Evidlo/motorcontroller/motor5/render/bottom.png

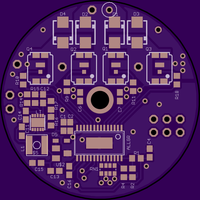
motor5/render/bottom.png
