Evidlo/motorcontroller/motor5/revision.md

* pending
    * increase size of C14 so it can be upgraded to a 50V rated cap

* applied
    * increase creepage on R9 and R11
    * change silkscreen version
    * 5k -> 1k
    * increase hole size for V+, GND, M+ and M- pins
    * move vias from under fets
    * increase hole size for bulk cap

    Attiny Pinout
