Evidlo/motorcontroller/motor7/plots/plots.docx

Side A Active (side A sourcing current)

Voltage across side A bootstrap

Voltage across side B bootstrap

Voltage on low side A FET gate

Voltage on low side B FET gate

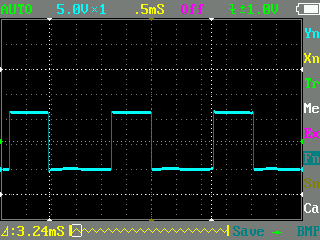
[picture p2: figure]

Side B Active (side B sourcing current)

Voltage across side A bootstrap

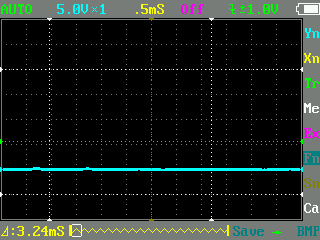
[picture p3: figure]

Voltage across side B bootstrap

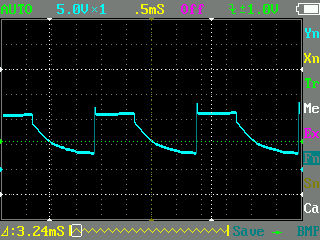
[picture p4: figure]

Voltage on low side A FET gate

Voltage on low side A FET gate

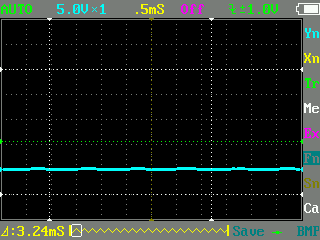
[picture p5: figure]
