Evidlo/motorcontroller/motor2/render/motor2-bottom.png

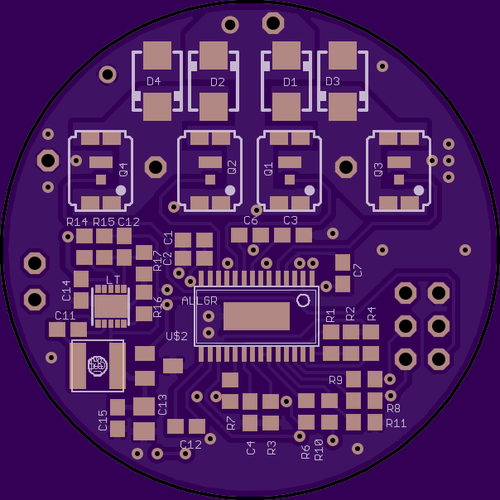
motor2/render/motor2-bottom.png
