Evidlo/motorcontroller/motor2/render/motor2-top.png

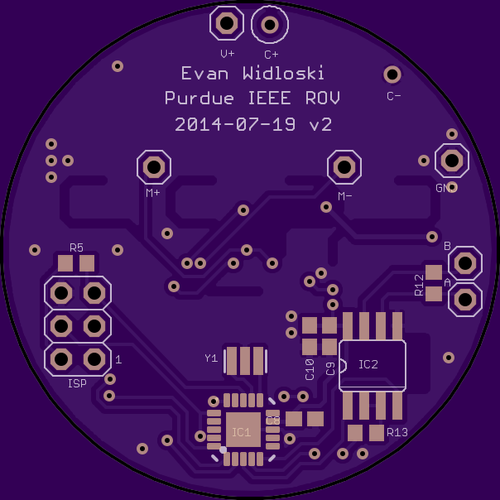
motor2/render/motor2-top.png
