Evidlo/motorcontroller/motor5/render/top.png

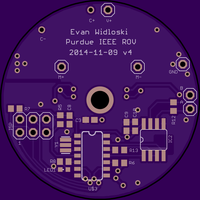
motor5/render/top.png
