Evidlo/motorcontroller/motor2/motor2_bom (Evan Widloski's conflicted copy 2014-08-30).ods

Seabotix Motor Controller BOM |  |  | 2014-07-22 | Evan Widloski
Qty | Value | Nom. Rating | Package | Parts | URL | Digikey Cost | Qty to Buy | Cost | Notes
1 |  |  | PINHD-2X3 | ISP
5 | .1uF | 25V | C-USC0603 | C2, C4, C8, C10, C16 | http://www.digikey.com/product-detail/en/CC0603ZRY5V9BB104/311-1343-1-ND/2103127 | 0.1 | 5 | 0.5
1 | .22uF | 25V | C-USC0603 | C11 | http://www.digikey.com/product-detail/en/TMK107B7224KA-T/587-1246-1-ND/931023 | 0.1 | 1 | 0.1
1 | 1M |  | R-US_R0603 | R15 | http://www.digikey.com/product-detail/en/RC0603FR-071ML/311-1.00MHRCT-ND/729791 | 0.1 | 1 | 0.1
2 | 1k |  | R-US_R0603 | R5, R10 | http://www.digikey.com/product-detail/en/RMCF0603JT1K00/RMCF0603JT1K00CT-ND/1943173 | 0.02 | 2 | 0.04
4 | 1uF | 25V | C-USC0603 | C3, C6, C7, C12 | http://www.digikey.com/product-detail/en/TMK107B7105KA-T/587-2984-1-ND/2714177 | 0.1 | 4 | 0.4
1 | 2.2uF | 100V | C-USC0603 | C13 | http://www.digikey.com/product-detail/en/CC0603ZRY5V5BB225/311-1452-1-ND/2833758 | 0.11 | 1 | 0.11
8 | 3k |  | R-US_R0603 | R1, R2, R6, R8, R11, R12, R14, R17 | http://www.digikey.com/product-detail/en/RMCF0603JT3K30/RMCF0603JT3K30CT-ND/1943182 | 0.02 | 8 | 0.16
2 | 10k |  | R-US_R0603 | R9, R13 | http://www.digikey.com/product-detail/en/RMCF0603JT10K0/RMCF0603JT10K0CT-ND/1943191 | 0.02 | 2 | 0.04
1 | 22pF | 25V | C-USC0603 | C15 | http://www.digikey.com/product-detail/en/C1608C0G1H220J080AA/445-1273-1-ND/567670 | 0.1 | 1 | 0.1
1 | 22uF | 25V | C-USC0603 | C14 | http://www.digikey.com/product-detail/en/CL21A226MAQNNNE/1276-2908-1-ND/3890994 | 0.47 | 1 | 0.47
2 | 51k |  | R-US_R0603 | R4,R7 | http://www.digikey.com/product-detail/en/RMCF0603FT51K1/RMCF0603FT51K1CT-ND/1943103 | 0.04 | 2 | 0.08
2 | 68nF | 25V | C-USC0603 | C1, C5 | http://www.digikey.com/product-detail/en/GRM188R71E683KA01D/490-1523-1-ND/587864 | 0.1 | 2 | 0.2
1 | 100K |  | R-US_R0603 | R16 | http://www.digikey.com/product-detail/en/RMCF0603FT100K/RMCF0603FT100KCT-ND/1943118 | 0.04 | 1 | 0.04
1 | 120 |  | R-US_R0603 | R3 | http://www.digikey.com/product-detail/en/RMCF0603JT120R/RMCF0603JT120RCT-ND/1943157 | 0.02 | 1 | 0.02
1 | ALLEGRO-A3921 |  | ALLEGRO-A3921 | U$1 | http://www.digikey.com/product-detail/en/A3921KLPTR-T/620-1523-1-ND/4318335 | 4.03 | 1 | 4.03
1 | ASPI-4030S |  | ASPI-4030S | U$5 | http://www.digikey.com/product-detail/en/ASPI-4030S-100M-T/535-12314-1-ND/4214914 | 0.5 | 1 | 0.5
1 | ATTINY84ATTINY84-QFN20 |  | ATTINY84ATTINY84-QFN20 | U$3 | http://www.digikey.com/product-detail/en/ATTINY84A-MU/ATTINY84A-MU-ND/3046450 | 1.78 | 1 | 1.78
1 | CSTCE16M0V53-R0 |  | CSTCE16M0V53-R0 | Y1 | http://www.digikey.com/product-detail/en/CSTCE16M0V53-R0/490-1198-1-ND/584635 | 0.48 | 1 | 0.48
4 | IRF6648 |  | IRF6648 | Q1, Q2, Q3, Q4 | http://www.digikey.com/product-detail/en/IRF6648TRPBF/IRF6648TRPBFCT-ND/1189869 | 4.26 | 0 | 0 | Salvage from Seabotix controllers
1 | LM3480-5 |  | LM3480-5 | U$7 | http://www.digikey.com/product-detail/en/LM3480IM3-5.0%2FNOPB/LM3480IM3-5.0%2FNOPBCT-ND/270751 | 0.97 | 1 | 0.97
1 | LT3990 |  | LT3990 | LT | http://www.digikey.com/product-detail/en/LT3990EDD%23PBF/LT3990EDD%23PBF-ND/2297579 | 5.45 | 1 | 5.45 | For bulk order: http://www.linear.com/purchase/LT3990
1 | MAX481CSA |  | MAX481CSA | IC2 | http://www.digikey.com/product-detail/en/MAX481CSA%2B/MAX481CSA%2B-ND/1495326 | 1.96 | 1 | 1.96
4 | MRA4003T3G |  | MRA4003T3G | U$2, U$8, U$9, U$10 | http://www.digikey.com/product-detail/en/MRA4003T3G/MRA4003T3GOSCT-ND/1139933 | 0.31 | 4 | 1.24
1 | 470uF or more | 100V | RADIAL-CAP | U$6 |  |  | 0 |  | Pull one out of electrolytic kit
 |  |  |  |  |  |  | Total | 18.77
