Evidlo/motorcontroller/motor5/motor5_bom.ods

Seabotix Motor Controller BOM |  |  | 2015-01-03 | Evan Widloski
Qty | Value | Max Rating | Package | Parts | URL | Part No | Unit Cost | Qty to Buy | Cost |  | Notes
1 |  |  | PINHD-2X3 | ISP |  |  |  | 0 |  |  | Already have
5 | .1uF | 25V | 603 | C2, C4, C8, C10, C15 | http://www.digikey.com/product-detail/en/CC0603ZRY5V9BB104/311-1343-1-ND/2103127 | 311-1343-1-ND | 0.1 | 40 | 4
1 | .22uF | 25V | 603 | C11 | http://www.digikey.com/product-detail/en/TMK107B7224KA-T/587-1246-1-ND/931023 | 587-1246-1-ND | 0.1 | 10 | 1
1 | 1M |  | 603 | R15 | http://www.digikey.com/product-detail/en/ERJ-3EKF1004V/P1.00MHCT-ND/198072 | P1.00MHCT-ND | 0.1 | 10 | 1
1 | 330 |  | 603 | R8 | http://www.digikey.com/product-detail/en/ERJ-3EKF3300V/P330HCT-ND/1746761 | P330HCT-ND | 0.1 | 10 | 1
3 | 1k |  | 603 | R2, R6,R13, R14 | http://www.digikey.com/product-detail/en/ERJ-3EKF1001V/P1.00KHCT-ND/198071 | P1.00KHCT-ND | 0.1 | 30 | 3
1 | 470nF |  | 603 | C16 | http://www.digikey.com/product-detail/en/UMK107B7474KA-TR/587-3170-1-ND/3194939 | 587-3170-1-ND | 0.24 | 10 | 2.4
4 | 10 |  | 603 | R9, R10, R11, R18 | http://www.digikey.com/product-detail/en/ERJ-3EKF10R0V/P10.0HCT-ND/198100 | P10.0HCT-ND | 0.1 | 40 | 4
1 | 4.7uF |  | 603 | C3 | http://www.digikey.com/product-detail/en/CL10B475KQ8NQNC/1276-2087-1-ND/3890173 | 1276-2087-1-ND | 0.1 | 10 | 1
4 | 1uF | 25V | 603 | C1, C3, C9 | http://www.digikey.com/product-detail/en/TMK107B7105KA-T/587-2984-1-ND/2714177 | 587-2984-1-ND | 0.1 | 40 | 4
1 | 2.2uF | 100V | 603 | C14 | http://www.digikey.com/product-detail/en/CC0603ZRY5V5BB225/311-1452-1-ND/2833758 | 311-1452-1-ND | 0.11 | 10 | 1.1
1 | 3.3k |  | 603 | R4 | http://www.digikey.com/product-detail/en/ERJ-3EKF3301V/P3.30KHCT-ND/1746762 | P3.30KHCT-ND | 0.1 | 10 | 1
2 | 10k |  | 603 | R1,R5 | http://www.digikey.com/product-detail/en/ERJ-3EKF1002V/P10.0KHCT-ND/198102 | P10.0KHCT-ND | 0.1 | 20 | 2
1 | 22pF | 25V | 603 | C12 | http://www.digikey.com/product-detail/en/C1608C0G1H220J080AA/445-1273-1-ND/567670 | 445-1273-1-ND | 0.1 | 10 | 1
1 | 22uF | 25V | 805 | C13 | http://www.digikey.com/product-detail/en/CL21A226MAQNNNE/1276-2908-1-ND/3890994 | 1276-2908-1-ND | 0.47 | 10 | 4.7
1 | 33k |  | 603 | R7 | http://www.digikey.com/product-detail/en/ERJ-3EKF3302V/P33.0KHCT-ND/1746763 | P33.0KHCT-ND | 0.1 | 10 | 1
1 | 51k |  | 603 | R16 | http://www.digikey.com/product-detail/en/ERJ-3EKF5102V/P51.0KHCT-ND/1746788 | P51.0KHCT-ND | 0.1 | 10 | 1
2 | 220nF | 25V | 603 | C6, C7 | http://www.digikey.com/product-detail/en/C1608X7R1C224K080AC/445-1318-1-ND/567690 | 445-1318-1-ND | 0.1 | 20 | 2
1 | 100K |  | 603 | R17 | http://www.digikey.com/product-detail/en/ERJ-3EKF1003V/P100KHCT-ND/198110 | P100KHCT-ND | 0.1 | 10 | 1
1 | 120 |  | 603 | R12 | http://www.digikey.com/product-detail/en/RMCF0603JT120R/RMCF0603JT120RCT-ND/1943157 | P120HCT-ND | 0.1 | 10 | 1
1 | 1k |  | EXB38V | RN1 | http://www.digikey.com/product-detail/en/ERJ-3EKF1200V/P120HCT-ND/1746726 | 742C083102JPCT-ND | 0.1 | 10 | 1
1 | 220 |  | 603 | R8 | http://www.digikey.com/product-detail/en/ERJ-3EKF2200V/P220HCT-ND/1746741 | P220HCT-ND | 0.1 | 10 | 1
1 | ALLEGRO-A3921 |  | ALLEGRO-A3921 | ALLGR | http://www.digikey.com/product-detail/en/A3921KLPTR-T/620-1523-1-ND/4318335 | 620-1523-1-ND | 4.03 | 10 | 40.3
1 | ASPI-4030S |  | ASPI-4030S | L1 | http://www.digikey.com/product-detail/en/ASPI-4030S-100M-T/535-12314-1-ND/4214914 | 535-12314-1-ND | 0.5 | 8 | 4
1 | ATTINY84 |  | SOIC14 | U$3 | http://www.digikey.com/product-detail/en/ATTINY84A-SSU/ATTINY84A-SSU-ND/3046522 | ATTINY84A-SSU-ND | 1.66 | 10 | 16.6
1 | CSTCE16M0V53-R0 |  | CSTCE16M0V53-R0 | Y1 | http://www.digikey.com/product-detail/en/CSTCE16M0V53-R0/490-1198-1-ND/584635 | 490-1198-1-ND | 0.48 | 8 | 3.84
4 | IRF6648 |  | IRF6648 | Q1, Q2, Q3, Q4 | http://www.digikey.com/product-detail/en/IRF6648TRPBF/IRF6648TRPBFCT-ND/1189869 | IRF6648TRPBFCT-ND | 4.26 | 0 | 0 |  | Salvage from Seabotix controllers
1 | LM3480-5 |  | 603 | U$2 | http://www.digikey.com/product-detail/en/LM3480IM3-5.0%2FNOPB/LM3480IM3-5.0%2FNOPBCT-ND/270751 | LM3480IM3-5.0/NOPBCT-ND | 0.97 | 10 | 9.7
1 | LT3990 |  | LT3990 | LT | http://www.digikey.com/product-detail/en/LT3990EDD%23PBF/LT3990EDD%23PBF-ND/2297579 | LT3990EDD#PBF-ND | 5.45 | 10 | 54.5
1 | MAX481CSA |  | MAX481CSA | IC2 | http://www.digikey.com/product-detail/en/MAX481CSA%2B/MAX481CSA%2B-ND/1495326 | MAX481CSA+-ND | 4 | 8 | 32
4 | MRA4003T3G |  | MRA4003T3G | D1, D2, D3, D4 | http://www.digikey.com/product-detail/en/MRA4003T3G/MRA4003T3GOSCT-ND/1139933 | MRA4003T3GOSCT-ND | 0.31 | 32 | 9.92
1 | DB2J310 |  | SOD-323F | D5 | http://www.digikey.com/product-detail/en/DB2J31000L/DB2J31000LCT-ND/2326085 | DB2J31000LCT-ND | 0.27 | 8 | 2.16
1 | 470uF or more | 100V | RADIAL-CAP |  |  |  |  | 0 | 0 |  | Pull one out of electrolytic kit
 | LED1 |  | 603 |  | http://www.digikey.com/product-detail/en/LG%20Q971-KN-1/475-1409-1-ND/1802597 | 475-1409-1-ND | 0.08 | 10 | 0.8
 |  |  |  |  |  |  |  |  |  | Total | 213.02
