Evidlo/motorcontroller/motor6/motor6_bom.ods

Seabotix Motor Controller BOM |  |  | 2015-01-03 | Evan Widloski
Qty | Value | Max Rating | Package | Parts | URL | Part No | Unit Cost | Qty to Buy | Cost | Notes
1 |  |  | PINHD-2X3 | ISP |  |  |  | 0
1 | 1M |  | 603 | R15 | http://www.digikey.com/product-detail/en/ERJ-3EKF1004V/P1.00MHCT-ND/198072 | P1.00MHCT-ND | 0.1 | 0 | 0
1 | 330 |  | 603 | R8 | http://www.digikey.com/product-detail/en/ERJ-3EKF3300V/P330HCT-ND/1746761 | P330HCT-ND | 0.1 | 0 | 0
4 | 1K |  | 603 | R2, R6,R13, R14 | http://www.digikey.com/product-detail/en/ERJ-3EKF1001V/P1.00KHCT-ND/198071 | P1.00KHCT-ND | 0.1 | 0 | 0
4 | 10 |  | 603 | R9, R10, R11, R18 | http://www.digikey.com/product-detail/en/ERJ-3EKF10R0V/P10.0HCT-ND/198100 | P10.0HCT-ND | 0.1 | 25 | 2.5
1 | 3.3K |  | 603 | R4 | http://www.digikey.com/product-detail/en/ERJ-3EKF3301V/P3.30KHCT-ND/1746762 | P3.30KHCT-ND | 0.1 | 0 | 0
2 | 10K |  | 603 | R1,R5 | http://www.digikey.com/product-detail/en/ERJ-3EKF1002V/P10.0KHCT-ND/198102 | P10.0KHCT-ND | 0.1 | 0 | 0
1 | 33K |  | 603 | R7 | http://www.digikey.com/product-detail/en/ERJ-3EKF3302V/P33.0KHCT-ND/1746763 | P33.0KHCT-ND | 0.1 | 0 | 0
1 | 51K |  | 603 | R16 | http://www.digikey.com/product-detail/en/ERJ-3EKF5102V/P51.0KHCT-ND/1746788 | P51.0KHCT-ND | 0.1 | 0 | 0
1 | 100K |  | 603 | R17 | http://www.digikey.com/product-detail/en/ERJ-3EKF1003V/P100KHCT-ND/198110 | P100KHCT-ND | 0.1 | 0 | 0
1 | 120 |  | 603 | R12 | http://www.digikey.com/product-detail/en/RMCF0603JT120R/RMCF0603JT120RCT-ND/1943157 | 742C083102JPCT-ND | 0.1 | 0 | 0
1 |  |  | EXB38V | RN1 | http://www.digikey.com/product-detail/en/742C083102JP/742C083102JPCT-ND/1124573 | 742C083102JPCT-ND | 0.1 | 0 | 0
1 | 220 |  | 603 | R8 | http://www.digikey.com/product-detail/en/ERJ-3EKF2200V/P220HCT-ND/1746741 | P220HCT-ND | 0.1 | 0 | 0
1 | 22pF | 25V | 603 | C12 | http://www.digikey.com/product-detail/en/C1608C0G1H220J080AA/445-1273-1-ND/567670 | 445-1273-1-ND | 0.1 | 0 | 0
1 | 22uF | 25V | 805 | C13 | http://www.digikey.com/product-detail/en/CL21A226MAQNNNE/1276-2908-1-ND/3890994 | 1276-2908-1-ND | 0.47 | 10 | 4.7
1 | 2.2uF | 16V | 603 | C3 | http://www.digikey.com/product-detail/en/C1608X6S1C225K080AC/445-7438-1-ND/2733510 | 445-7438-1-ND | 0.24 | 10 | 2.4
2 | 1uF | 25V | 603 | C1, C9 | http://www.digikey.com/product-detail/en/TMK107B7105KA-T/587-2984-1-ND/2714177 | 587-2984-1-ND | 0.1 | 25 | 2.5
1 | .47uF | 25V | 603 | C16 | http://www.digikey.com/product-detail/en/UMK107B7474KA-TR/587-3170-1-ND/3194939 | 587-3170-1-ND | 0.24 | 25 | 6
5 | .1uF | 25V | 603 | C2, C4, C8, C10, C15 | http://www.digikey.com/product-detail/en/GRM188R71E104KA01D/490-1524-1-ND/587865 | 490-1524-1-ND | 0.1 | 0 | 0
3 | .22uF | 25V | 603 | C11,C6,C7 | http://www.digikey.com/product-detail/en/TMK107B7224KA-T/587-1246-1-ND/931023 | 587-1246-1-ND | 0.1 | 25 | 2.5
 |  |  | RADIAL-CAP |  |  |  |  |  | 0
1 |  |  | ASPI-4030S | L1 | http://www.digikey.com/product-detail/en/ASPI-4030S-100M-T/535-12314-1-ND/4214914 | 535-12314-1-ND | 0.5 | 0 | 0
1 |  |  |  | LED1 | http://www.digikey.com/product-detail/en/LNJP12X8ARA/LNJP12X8ARACT-ND/2641775 | LNJP12X8ARACT-ND | 0.48 | 10 | 4.8
1 |  |  | ALLEGRO-A3921 | ALLGR | http://www.digikey.com/product-detail/en/A3921KLPTR-T/620-1523-1-ND/4318335 | 620-1523-1-ND | 4.03 | 0 | 0
1 |  |  | SOIC14 | U$3 | http://www.digikey.com/product-detail/en/ATTINY84A-SSU/ATTINY84A-SSU-ND/3046522 | ATTINY84A-SSU-ND | 1.66 | 0 | 0
1 |  |  | CSTCE16M0V53-R0 | Y1 | http://www.digikey.com/product-detail/en/CSTCE16M0V53-R0/490-1198-1-ND/584635 | 490-1198-1-ND | 0.48 | 0 | 0
4 |  |  | IRF6648 | Q1, Q2, Q3, Q4 | http://www.digikey.com/product-detail/en/IRF6648TRPBF/IRF6648TRPBFCT-ND/1189869 | IRF6648TRPBFCT-ND | 4.26 | 0 | 0
1 |  |  |  | U$2 | http://www.digikey.com/product-detail/en/LM3480IM3-5.0%2FNOPB/LM3480IM3-5.0%2FNOPBCT-ND/270751 | LM3480IM3-5.0/NOPBCT-ND | 0.97 |  | 0
1 |  |  | LT3990 | LT | http://www.digikey.com/product-detail/en/LT3990EDD%23PBF/LT3990EDD%23PBF-ND/2297579 | LT3990EDD#PBF-ND | 5.45 | 0 | 0
1 |  |  | MAX481CSA | IC2 | http://www.digikey.com/product-detail/en/MAX481CSA%2B/MAX481CSA%2B-ND/1495326 | MAX481CSA+-ND | 4 | 0 | 0
4 |  |  | MRA4003T3G | D1, D2, D3, D4 | http://www.digikey.com/product-detail/en/MRA4003T3G/MRA4003T3GOSCT-ND/1139933 | MRA4003T3GOSCT-ND | 0.31 | 0 | 0
1 |  |  | SOD-323F | D5 | http://www.digikey.com/product-detail/en/DB2J31000L/DB2J31000LCT-ND/2326085 | DB2J31000LCT-ND | 0.27 | 0 | 0
