Evidlo/motorcontroller/motor6/revisions.md

pending
------
- add via to probe 12V from top of board
- add ziptie holes for wire strain relief
- add zener protection diode on 5V line

applied
-------
- switch to max 3442
- move c10 label from via
- c13 label too big
