Evidlo/motorcontroller/motor2/motor2-bottom.pdf

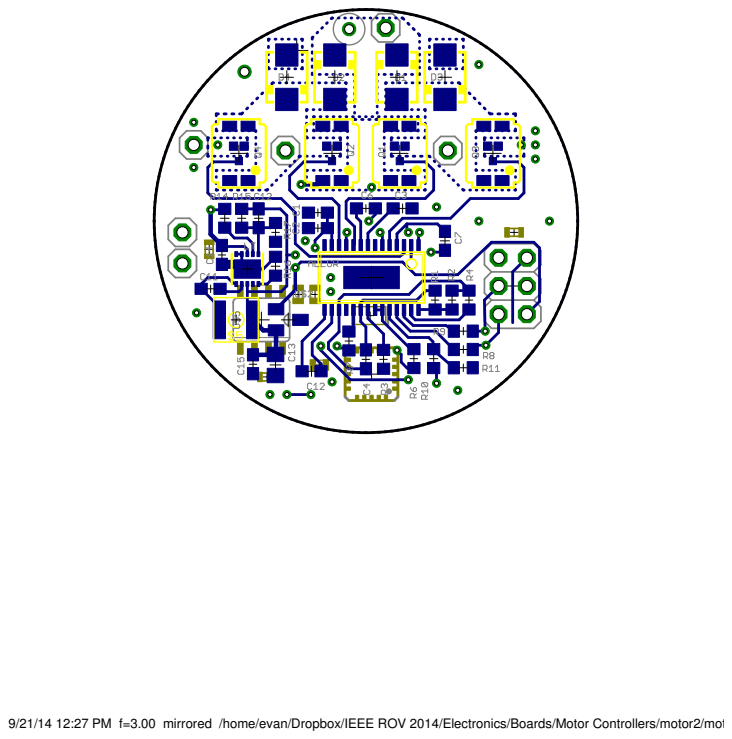
[picture p9: page 1]

9/21/14 12:27 PM f=3.00 mirrored /home/evan/Dropbox/IEEE ROV 2014/Electronics/Boards/Motor Controllers/motor2/motor2.brd
