Evidlo/motorcontroller/motor7/simulation/irf6648.cir

.SUBCKT irf6648 1 2 3
* SPICE3 MODEL WITH THERMAL RC NETWORK
**************************************
*      Model Generated by MODPEX     *
*Copyright(c) Symmetry Design Systems*
*         All Rights Reserved        *
*    UNPUBLISHED LICENSED SOFTWARE   *
*   Contains Proprietary Information *
*      Which is The Property of      *
*     SYMMETRY OR ITS LICENSORS      *
*Commercial Use or Resale Restricted *
*   by Symmetry License Agreement    *
**************************************
* Model generated on Nov 21, 05
* MODEL FORMAT: SPICE3
* Symmetry POWER MOS Model (Version 1.0)
* External Node Designations
* Node 1 -> Drain
* Node 2 -> Gate
* Node 3 -> Source
M1 9 7 8 8 MM L=100u W=100u
.MODEL MM NMOS LEVEL=1 IS=1e-32
+VTO=5.37094 LAMBDA=0 KP=139.191
+CGSO=1.92056e-05 CGDO=8.15929e-07
RS 8 3 0.00372047
D1 3 1 MD
.MODEL MD D IS=1.49295e-08 RS=0.00192064 N=1.2683 BV=60
+IBV=0.00025 EG=1 XTI=2.78917 TT=1e-07
+CJO=2.97508e-09 VJ=0.743179 M=0.543566 FC=0.496765
RDS 3 1 1e+07
RD 9 1 0.0001
RG 2 7 2.48227
D2 4 5 MD1
* Default values used in MD1:
*   RS=0 EG=1.11 XTI=3.0 TT=0
*   BV=infinite IBV=1mA
.MODEL MD1 D IS=1e-32 N=50
+CJO=1.15181e-09 VJ=0.5 M=0.649844 FC=1e-08
D3 0 5 MD2
* Default values used in MD2:
*   EG=1.11 XTI=3.0 TT=0 CJO=0
*   BV=infinite IBV=1mA
.MODEL MD2 D IS=1e-10 N=0.769847 RS=3e-06
RL 5 10 1
FI2 7 9 VFI2 -1
VFI2 4 0 0
EV16 10 0 9 7 1
CAP 11 10 1.15181e-09
FI1 7 9 VFI1 -1
VFI1 11 6 0
RCAP 6 10 1
D4 0 6 MD3
* Default values used in MD3:
*   EG=1.11 XTI=3.0 TT=0 CJO=0
*   RS=0 BV=infinite IBV=1mA
.MODEL MD3 D IS=1e-10 N=0.769847
.ENDS irf6648

*SPICE Thermal Model Subcircuit
.SUBCKT irf6648t 3 0

R_RTHERM1         3 2  0.171985579
R_RTHERM2         2 1  0.676725865
R_RTHERM3         1 0  0.549606089
C_CTHERM1         3 0  0.000255835
C_CTHERM2         2 0  0.002452987
C_CTHERM3         1 0  0.01391724

.ENDS irf6648t
