Evidlo/motorcontroller/motor3/motor3.brd

## EAGLE design motor3/motor3.brd (2015-09-03)

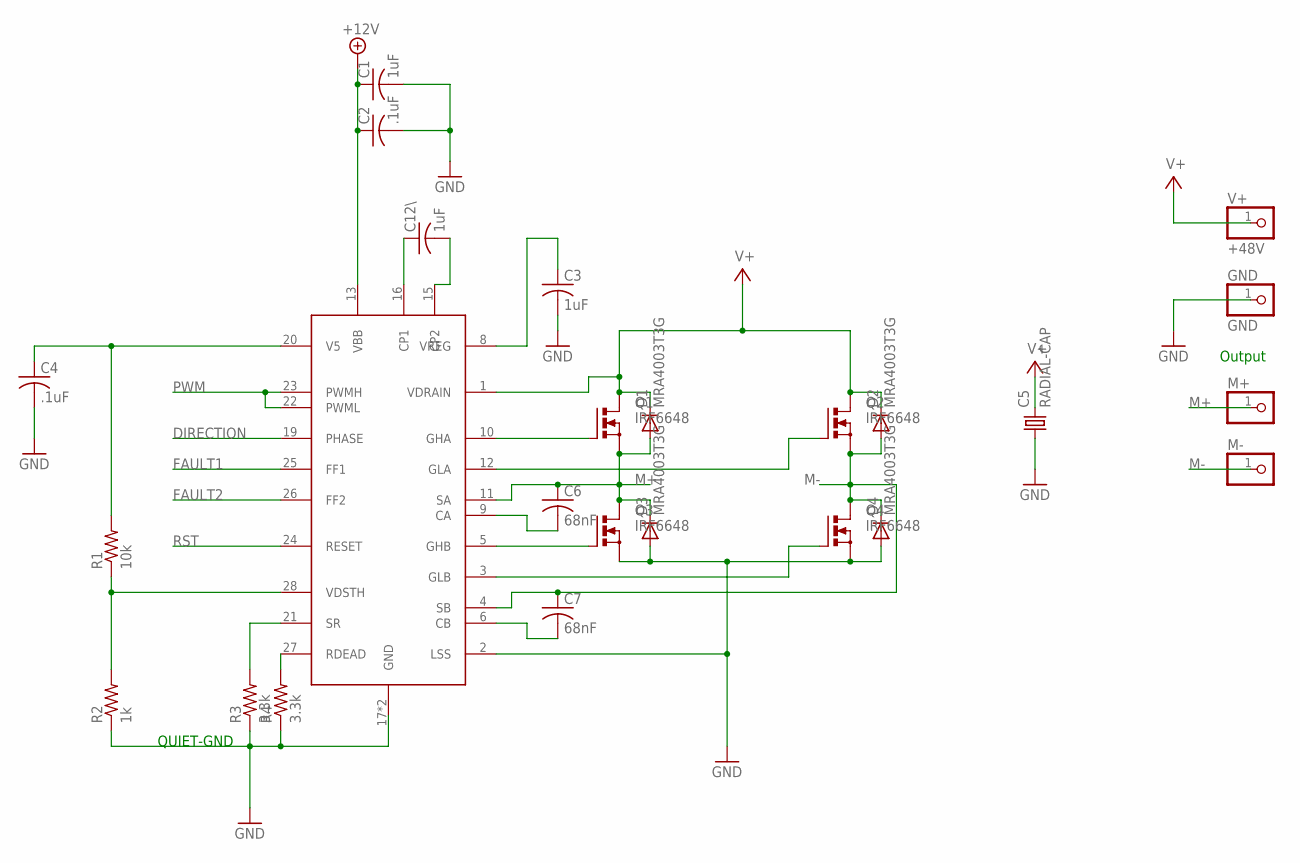
[picture p10: schematic motor3.sch, sheet 1]

Parts:
ALLGR: ALLEGRO-A3921; TSSOP28
C1, C3, C12\: 1uF; C0603
C2, C4: .1uF; C0603
C5: RADIAL-CAP
C6, C7: 68nF; C0603
D1, D2, D3, D4: MRA4003T3G; SMA
GND: GND; 1X01
M+: PINHD-1X1; 1X01
M-: PINHD-1X1; 1X01
Q1, Q2, Q3, Q4: IRF6648; DIRECTFET
R1: 10k; R0603
R2: 1k; R0603
R3, R4: 3.3k; R0603
V+: +48V; 1X01

Connections:
+5V-A: ALLGR.20 (V5), C4.1, R1.2
+12V: ALLGR.13 (VBB), C1.1, C2.1; also elsewhere on the board
+48V: ALLGR.1 (VDRAIN), C5.P$1 (2), D1.C, D2.C, Q1.D@1 (D), Q1.D@2 (D), Q1.D@3 (D), Q1.D@4 (D), Q2.D@1 (D), Q2.D@2 (D), Q2.D@3 (D), Q2.D@4 (D), V+.1; also elsewhere on the board
DIRECTION: ALLGR.19 (PHASE); also elsewhere on the board
FAULT1: ALLGR.25 (FF1); also elsewhere on the board
FAULT2: ALLGR.26 (FF2); also elsewhere on the board
GND: ALLGR.2 (LSS), ALLGR.17 (GND), ALLGR.P$1 (GND), C1.2, C2.2, C3.2, C4.2, C5.P$2 (1), D3.A, D4.A, GND.1, Q3.S@1 (S), Q3.S@2 (S), Q4.S@1 (S), Q4.S@2 (S), R2.1, R3.1, R4.1; also elsewhere on the board
M+: ALLGR.11 (SA), C6.1, D1.A, D3.C, M+.1, Q1.S@1 (S), Q1.S@2 (S), Q3.D@1 (D), Q3.D@2 (D), Q3.D@3 (D), Q3.D@4 (D)
M-: ALLGR.4 (SB), C7.1, D2.A, D4.C, M-.1, Q2.S@1 (S), Q2.S@2 (S), Q4.D@1 (D), Q4.D@2 (D), Q4.D@3 (D), Q4.D@4 (D)
unnamed: ALLGR.8 (VREG), C3.1
unnamed: ALLGR.16 (CP1), C12\.1
unnamed: ALLGR.15 (CP2), C12\.2
unnamed: ALLGR.10 (GHA), Q1.G
unnamed: ALLGR.12 (GLA), Q2.G
unnamed: ALLGR.3 (GLB), Q4.G
unnamed: ALLGR.6 (CB), C7.2
unnamed: ALLGR.9 (CA), C6.2
unnamed: ALLGR.28 (VDSTH), R1.1, R2.2
unnamed: ALLGR.27 (RDEAD), R4.2
unnamed: ALLGR.5 (GHB), Q3.G
unnamed: ALLGR.21 (SR), R3.2
PWM: ALLGR.22 (PWML), ALLGR.23 (PWMH); also elsewhere on the board
RST: ALLGR.24 (RESET); also elsewhere on the board

Notes on the sheet:
QUIET-GND
Output

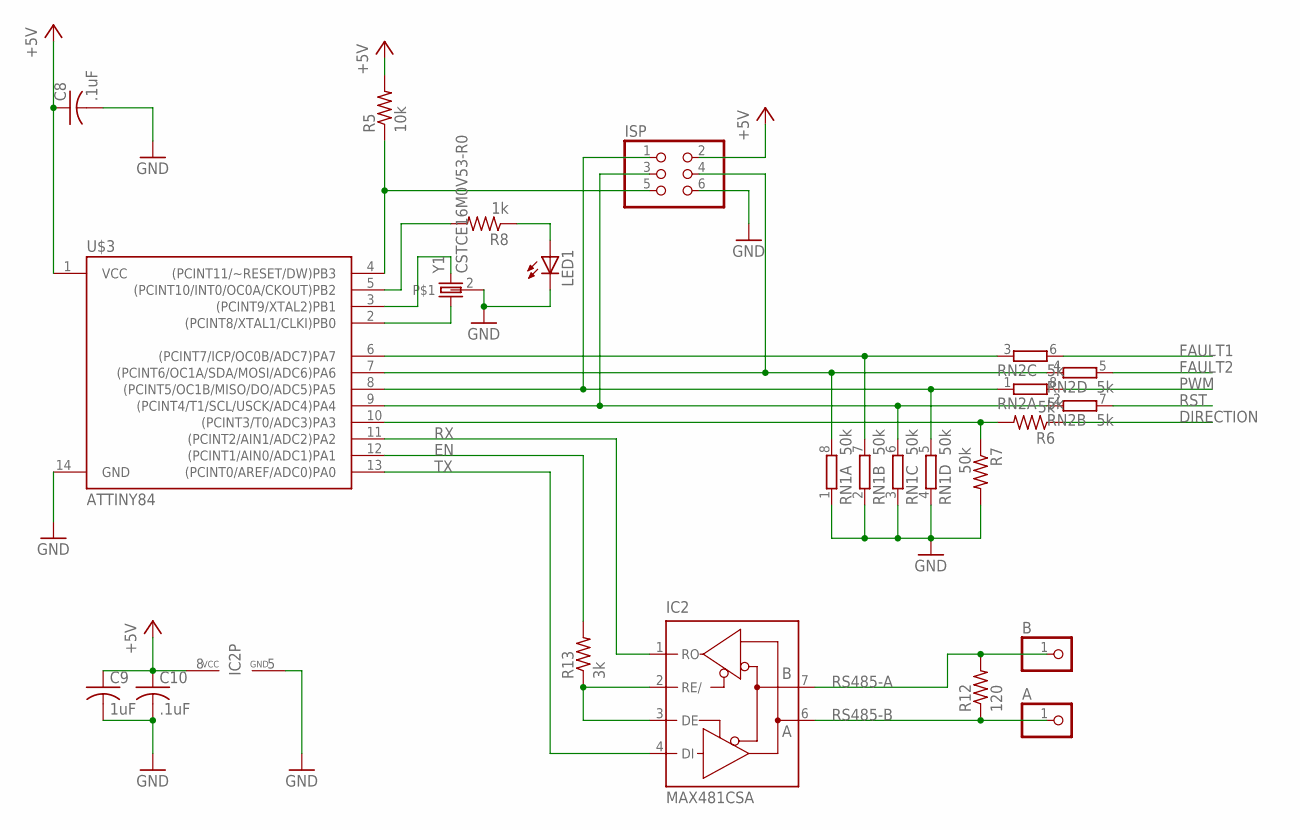
[picture p11: schematic motor3.sch, sheet 2]

Parts:
A: PINHD-1X1; 1X01
B: PINHD-1X1; 1X01
C8, C10: .1uF; C0603
C9: 1uF; C0603
IC2: MAX481CSA; SO08
ISP: PINHD-2X3; 2X03
LED1: LEDCHIPLED_0603; CHIPLED_0603
R5: 10k; R0603
R6: 5k; R0603
R7: 50k; R0603
R8: 1k; R0603
R12: 120; R0603
R13: 3k; R0603
RN1: 50k; EXB38V
RN2: 5k; EXB38V
U$3: ATTINY84; SO14
Y1: CSTCE16M0V53-R0; MYSMD2_RESONATOR

Connections:
+5V: C8.1, C9.1, C10.1, IC2.8 (VCC), ISP.2, R5.2, U$3.1 (VCC); also elsewhere on the board
DIRECTION: R6.1; also elsewhere on the board
EN: R13.2, U$3.12 ((PCINT1/AIN0/ADC1)PA1)
FAULT1: RN2.6 (2); also elsewhere on the board
FAULT2: RN2.5 (2); also elsewhere on the board
GND: C8.2, C9.2, C10.2, IC2.5 (GND), ISP.6, LED1.C, R7.2, RN1.1, RN1.2 (1), RN1.3 (1), RN1.4 (1), U$3.14 (GND), Y1.2; also elsewhere on the board
unnamed: ISP.1, RN1.5 (2), RN2.1, U$3.8 ((PCINT5/OC1B/MISO/DO/ADC5)PA5)
unnamed: ISP.4, RN1.8 (2), RN2.4 (1), U$3.7 ((PCINT6/OC1A/SDA/MOSI/ADC6)PA6)
unnamed: ISP.5, R5.1, U$3.4 ((PCINT11/~RESET/DW)PB3)
unnamed: IC2.2 (RE/), IC2.3 (DE), R13.1
unnamed: U$3.2 ((PCINT8/XTAL1/CLKI)PB0), Y1.1
unnamed: RN1.7 (2), RN2.3 (1), U$3.6 ((PCINT7/ICP/OC0B/ADC7)PA7)
unnamed: R6.2, R7.1, U$3.10 ((PCINT3/T0/ADC3)PA3)
unnamed: U$3.3 ((PCINT9/XTAL2)PB1), Y1.3 (2)
unnamed: LED1.A, R8.1
unnamed: R8.2, U$3.5 ((PCINT10/INT0/OC0A/CKOUT)PB2)
OIJWOIJ3: ISP.3, RN1.6 (2), RN2.2 (1), U$3.9 ((PCINT4/T1/SCL/USCK/ADC4)PA4)
PWM: RN2.8 (2); also elsewhere on the board
RS485-A: B.1, IC2.7 (B), R12.2
RS485-B: A.1, IC2.6 (A), R12.1
RST: RN2.7 (2); also elsewhere on the board
RX: IC2.1 (RO), U$3.11 ((PCINT2/AIN1/ADC2)PA2)
TX: IC2.4 (DI), U$3.13 ((PCINT0/AREF/ADC0)PA0)

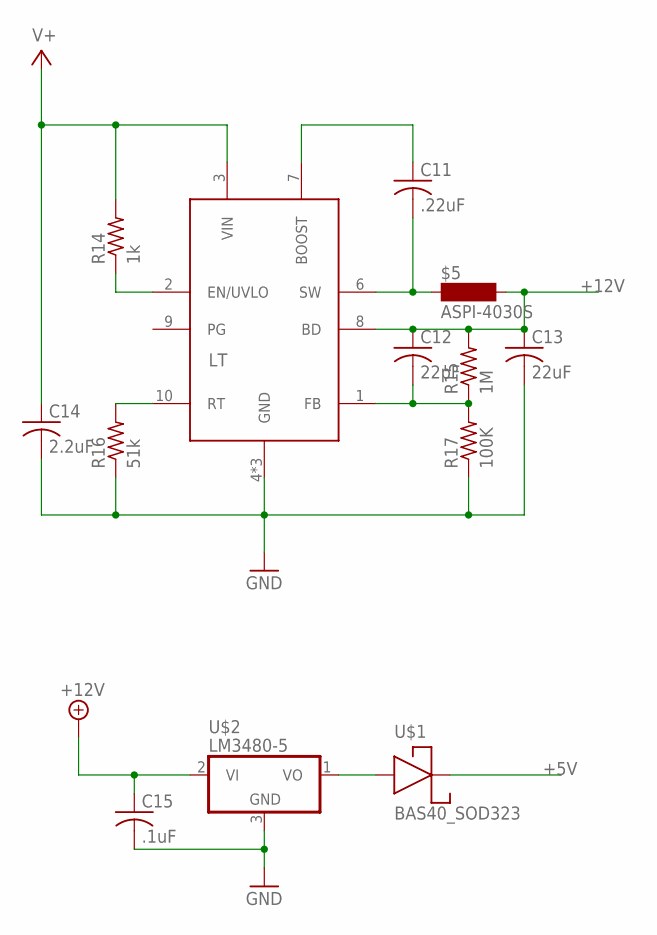
[picture p12: schematic motor3.sch, sheet 3]

Parts:
$5: ASPI-4030S
C11: .22uF; C0603
C12: 22pF; C0603
C13: 22uF; C0805
C14: 2.2uF; C0603
C15: .1uF; C0603
LT: LT3990; DFN10-3X3
R14: 1k; R0603
R15: 1M; R0603
R16: 51k; R0603
R17: 100K; R0603
U$1: BAS40_SOD323; SOD323
U$2: LM3480-5; SOT23

Connections:
+5V: U$1.1; also elsewhere on the board
+12V: $5.P$2 (2), C12.1, C13.1, C15.1, LT.8 (BD), R15.2, U$2.2 (VI); also elsewhere on the board
+48V: C14.1, LT.3 (VIN), R14.2; also elsewhere on the board
GND: C13.2, C14.2, C15.2, LT.4 (GND), LT.5 (GND), LT.EXP (GND), R16.1, R17.1, U$2.3 (GND); also elsewhere on the board
unnamed: C11.1, LT.7 (BOOST)
unnamed: $5.P$1 (1), C11.2, LT.6 (SW)
unnamed: C12.2, LT.1 (FB), R15.1, R17.2
unnamed: LT.10 (RT), R16.2
unnamed: U$1.2, U$2.1 (VO)
unnamed: LT.2 (EN/UVLO), R14.1

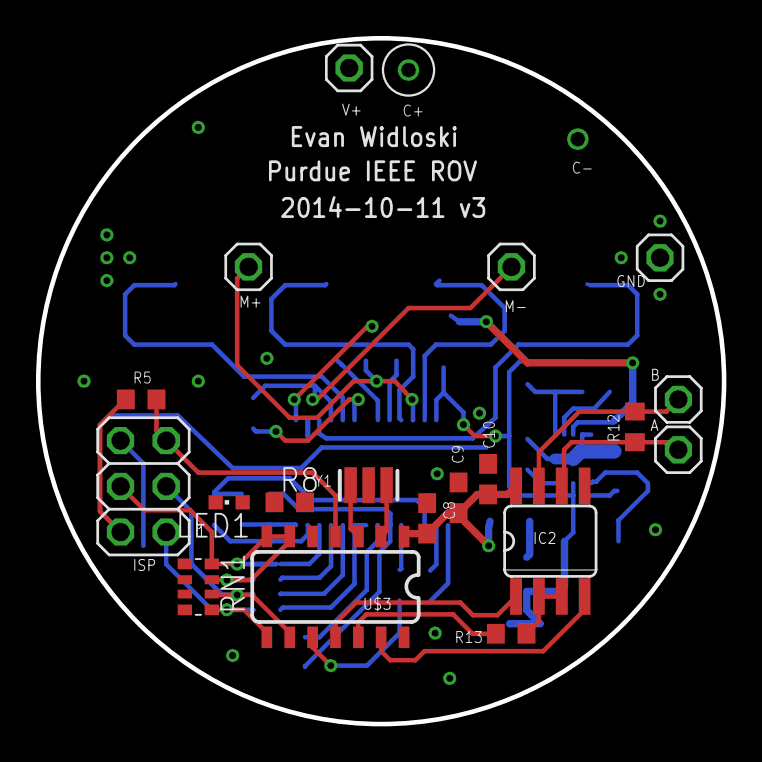
[picture p13: board motor3.brd from above]

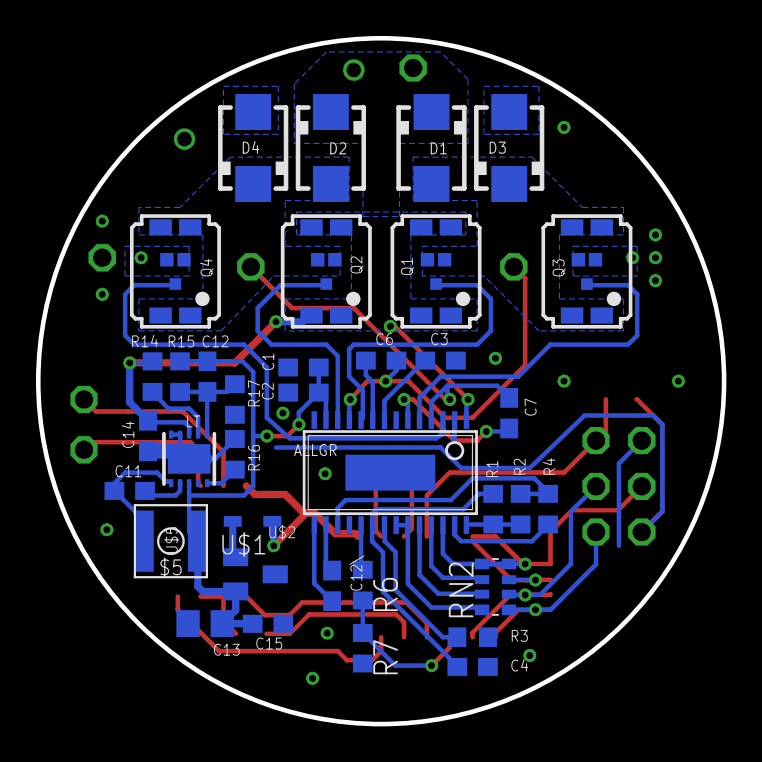
[picture p14: board motor3.brd from below]

Board: 2 copper layers, 38.1 x 38.1 mm, 56 parts (36 on the bottom side), 46 nets.
