Evidlo/motorcontroller/motor7/motor7.brd

## EAGLE design motor7/motor7.brd (2015-09-03)

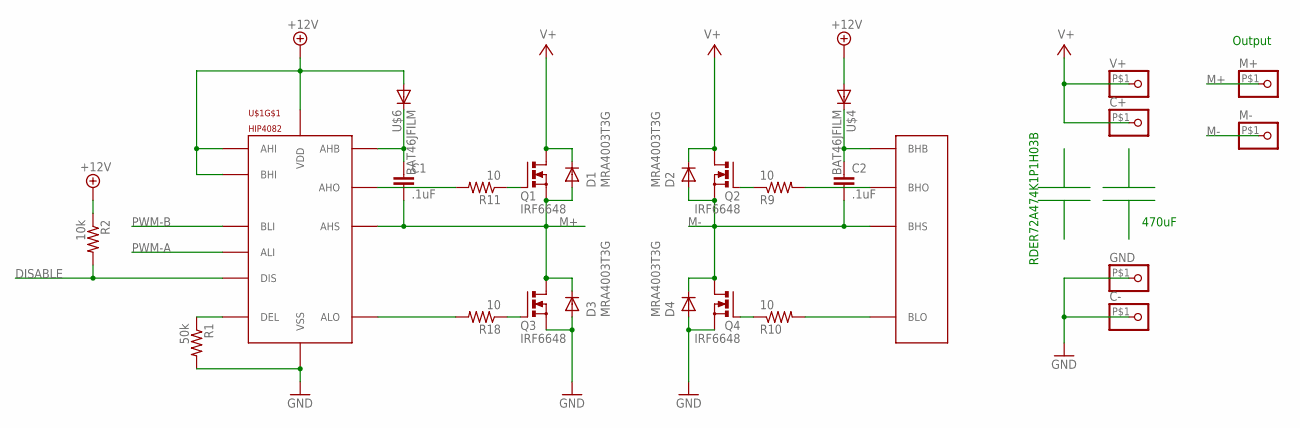
[picture p15: schematic motor7.sch, sheet 1]

Parts:
C1, C2: .1uF; C0603
C+: PINHD-1X1; 1X01
C-: PINHD-1X1; 1X01
D1, D2, D3, D4: MRA4003T3G; SMA
GND: PINHD-1X1; 1X01
M+: PINHD-1X1; 1X01
M-: PINHD-1X1; 1X01
Q1, Q2: IRF6648; DIRECTFET-MOD
Q3, Q4: IRF6648; DIRECTFET
R1: 50k; R0603
R2: 10k; R0603
R9, R10, R11, R18: 10; R0603
U$1: HIP4082; SOIC16
U$4, U$6: BAT46JFILM; SOD323
V+: PINHD-1X1; 1X01

Connections:
+12V: R2.1, U$1.2 (BHI), U$1.7 (AHI), U$1.12 (VDD), U$4.2 (A), U$6.2 (A); also elsewhere on the board
+48V: C+.P$1, D1.C, D2.C, Q1.D@1 (D), Q1.D@2 (D), Q1.D@3 (D), Q1.D@4 (D), Q2.D@1 (D), Q2.D@2 (D), Q2.D@3 (D), Q2.D@4 (D), V+.P$1; also elsewhere on the board
DISABLE: R2.2, U$1.8 (DIS); also elsewhere on the board
GND: C-.P$1, D3.A, D4.A, GND.P$1, Q3.S@1 (S), Q3.S@2 (S), Q4.S@1 (S), Q4.S@2 (S), R1.2, U$1.6 (VSS); also elsewhere on the board
M+: C1.2, D1.A, D3.C, M+.P$1, Q1.S@1 (S), Q1.S@2 (S), Q3.D@1 (D), Q3.D@2 (D), Q3.D@3 (D), Q3.D@4 (D), U$1.11 (AHS)
M-: C2.2, D2.A, D4.C, M-.P$1, Q2.S@1 (S), Q2.S@2 (S), Q4.D@1 (D), Q4.D@2 (D), Q4.D@3 (D), Q4.D@4 (D), U$1.15 (BHS)
unnamed: C1.1, U$1.9 (AHB), U$6.1 (C)
unnamed: R11.2, U$1.10 (AHO)
unnamed: R18.2, U$1.13 (ALO)
unnamed: C2.1, U$1.1 (BHB), U$4.1 (C)
unnamed: Q1.G, R11.1
unnamed: R10.2, U$1.14 (BLO)
unnamed: R9.2, U$1.16 (BHO)
unnamed: Q3.G, R18.1
unnamed: Q2.G, R9.1
unnamed: Q4.G, R10.1
unnamed: R1.1, U$1.5 (DEL)
PWM-A: U$1.4 (ALI); also elsewhere on the board
PWM-B: U$1.3 (BLI); also elsewhere on the board

Notes on the sheet:
Output
470uF
RDER72A474K1P1H03B

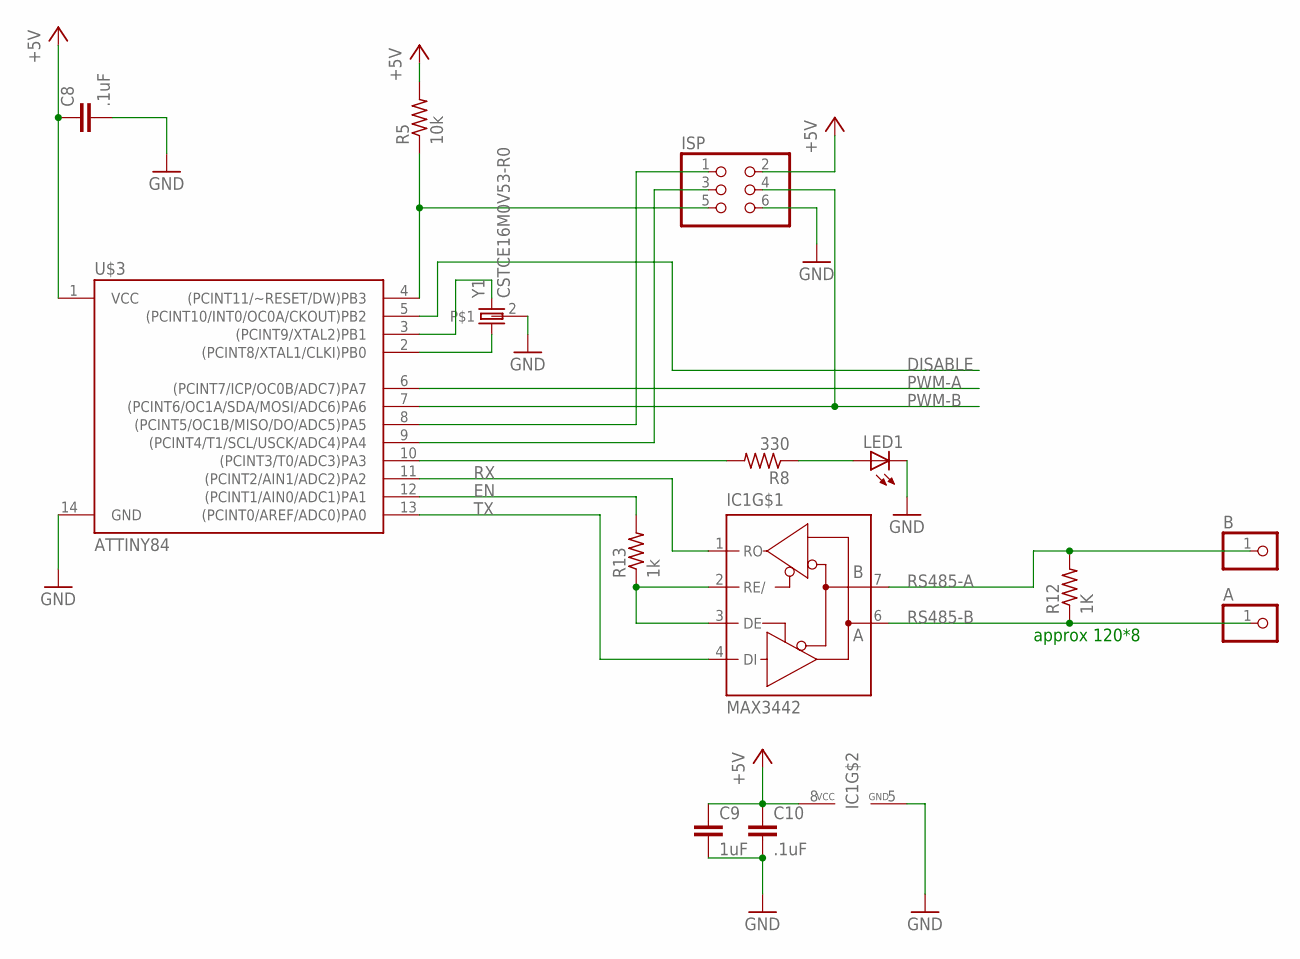
[picture p16: schematic motor7.sch, sheet 2]

Parts:
A: PINHD-1X1; 1X01
B: PINHD-1X1; 1X01
C8, C10: .1uF; C0603
C9: 1uF; C0603
IC1: MAX3442; SO08
ISP: PINHD-2X3; 2X03
LED1: LEDCHIPLED_0603; CHIPLED_0603
R5: 10k; R0603
R8: 330; R0603
R12: 1K; R0603
R13: 1k; R0603
U$3: ATTINY84; SO14
Y1: CSTCE16M0V53-R0; MYSMD2_RESONATOR

Connections:
23JOIJO: ISP.1, U$3.8 ((PCINT5/OC1B/MISO/DO/ADC5)PA5)
+5V: C8.1, C9.1, C10.1, IC1.8 (VCC), ISP.2, R5.2, U$3.1 (VCC); also elsewhere on the board
DISABLE: U$3.5 ((PCINT10/INT0/OC0A/CKOUT)PB2); also elsewhere on the board
EN: R13.2, U$3.12 ((PCINT1/AIN0/ADC1)PA1)
GND: C8.2, C9.2, C10.2, IC1.5 (GND), ISP.6, LED1.C, U$3.14 (GND), Y1.2; also elsewhere on the board
unnamed: IC1.2 (RE/), IC1.3 (DE), R13.1
unnamed: U$3.2 ((PCINT8/XTAL1/CLKI)PB0), Y1.1
unnamed: R8.2, U$3.10 ((PCINT3/T0/ADC3)PA3)
unnamed: U$3.3 ((PCINT9/XTAL2)PB1), Y1.3 (2)
unnamed: LED1.A, R8.1
unnamed: ISP.5, R5.1, U$3.4 ((PCINT11/~RESET/DW)PB3)
OIJWOIJ3: ISP.3, U$3.9 ((PCINT4/T1/SCL/USCK/ADC4)PA4)
PWM-A: U$3.6 ((PCINT7/ICP/OC0B/ADC7)PA7); also elsewhere on the board
PWM-B: ISP.4, U$3.7 ((PCINT6/OC1A/SDA/MOSI/ADC6)PA6); also elsewhere on the board
RS485-A: B.1, IC1.7 (B), R12.2
RS485-B: A.1, IC1.6 (A), R12.1
RX: IC1.1 (RO), U$3.11 ((PCINT2/AIN1/ADC2)PA2)
TX: IC1.4 (DI), U$3.13 ((PCINT0/AREF/ADC0)PA0)

Notes on the sheet:
approx 120*8

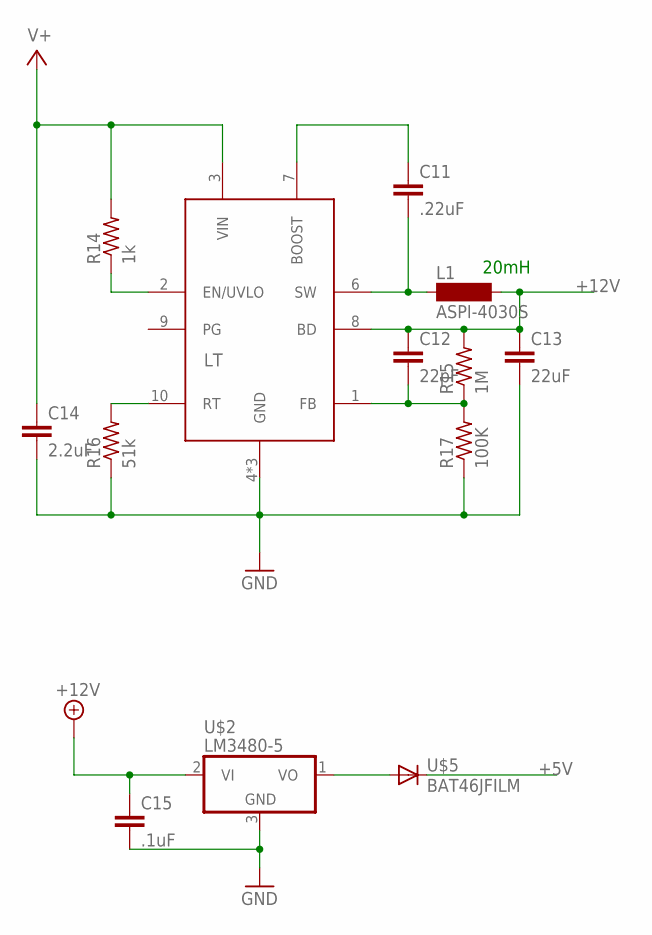
[picture p17: schematic motor7.sch, sheet 3]

Parts:
C11: .22uF; C0603
C12: 22pF; C0603
C13: 22uF; C0805
C14: 2.2uF; C0603
C15: .1uF; C0603
L1: ASPI-4030S
LT: LT3990; DFN10-3X3
R14: 1k; R0603
R15: 1M; R0603
R16: 51k; R0603
R17: 100K; R0603
U$2: LM3480-5; SOT23
U$5: BAT46JFILM; SOD323

Connections:
+5V: U$5.1 (C); also elsewhere on the board
+12V: C12.1, C13.1, C15.1, L1.P$2 (2), LT.8 (BD), R15.2, U$2.2 (VI); also elsewhere on the board
+48V: C14.1, LT.3 (VIN), R14.2; also elsewhere on the board
GND: C13.2, C14.2, C15.2, LT.4 (GND), LT.5 (GND), LT.EXP (GND), R16.1, R17.1, U$2.3 (GND); also elsewhere on the board
unnamed: C11.1, LT.7 (BOOST)
unnamed: C11.2, L1.P$1 (1), LT.6 (SW)
unnamed: C12.2, LT.1 (FB), R15.1, R17.2
unnamed: LT.10 (RT), R16.2
unnamed: U$2.1 (VO), U$5.2 (A)
unnamed: LT.2 (EN/UVLO), R14.1

Notes on the sheet:
20mH

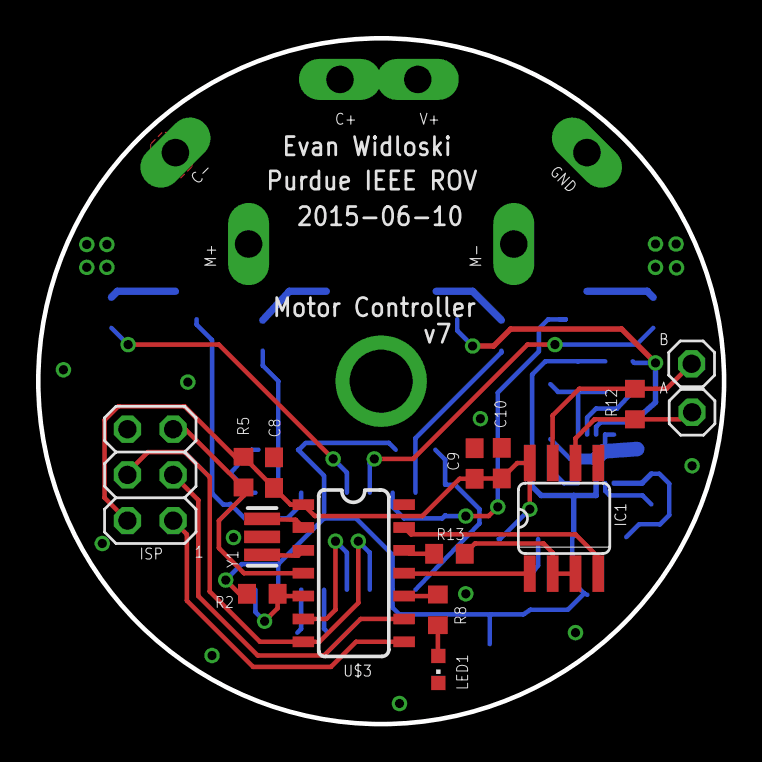
[picture p18: board motor7.brd from above]

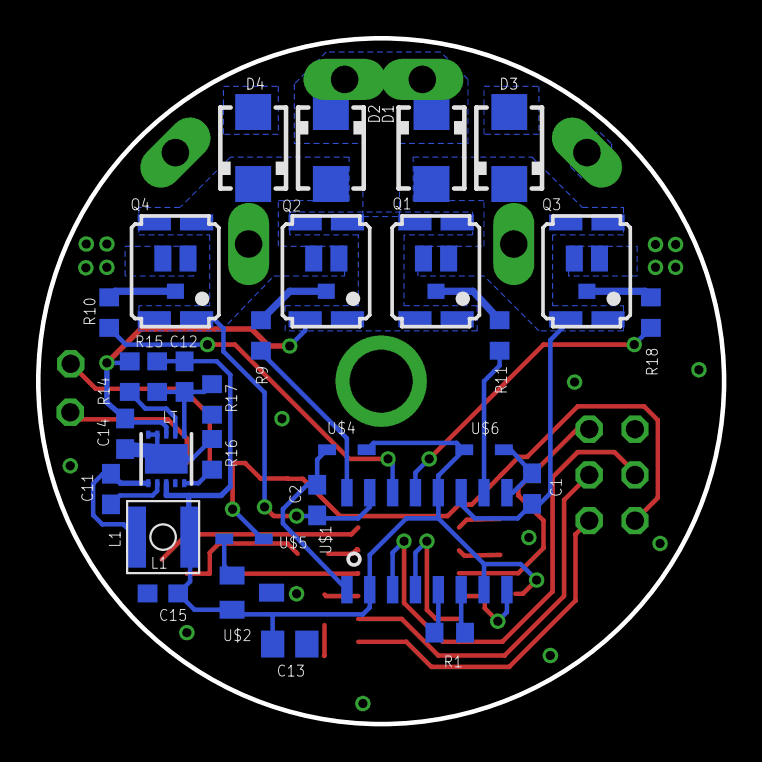
[picture p19: board motor7.brd from below]

Board: 2 copper layers, 38.1 x 38.1 mm, 52 parts (31 on the bottom side), 39 nets.
