Evidlo/motorcontroller/motor/motor.brd

## EAGLE design motor/motor.brd (2015-09-03)

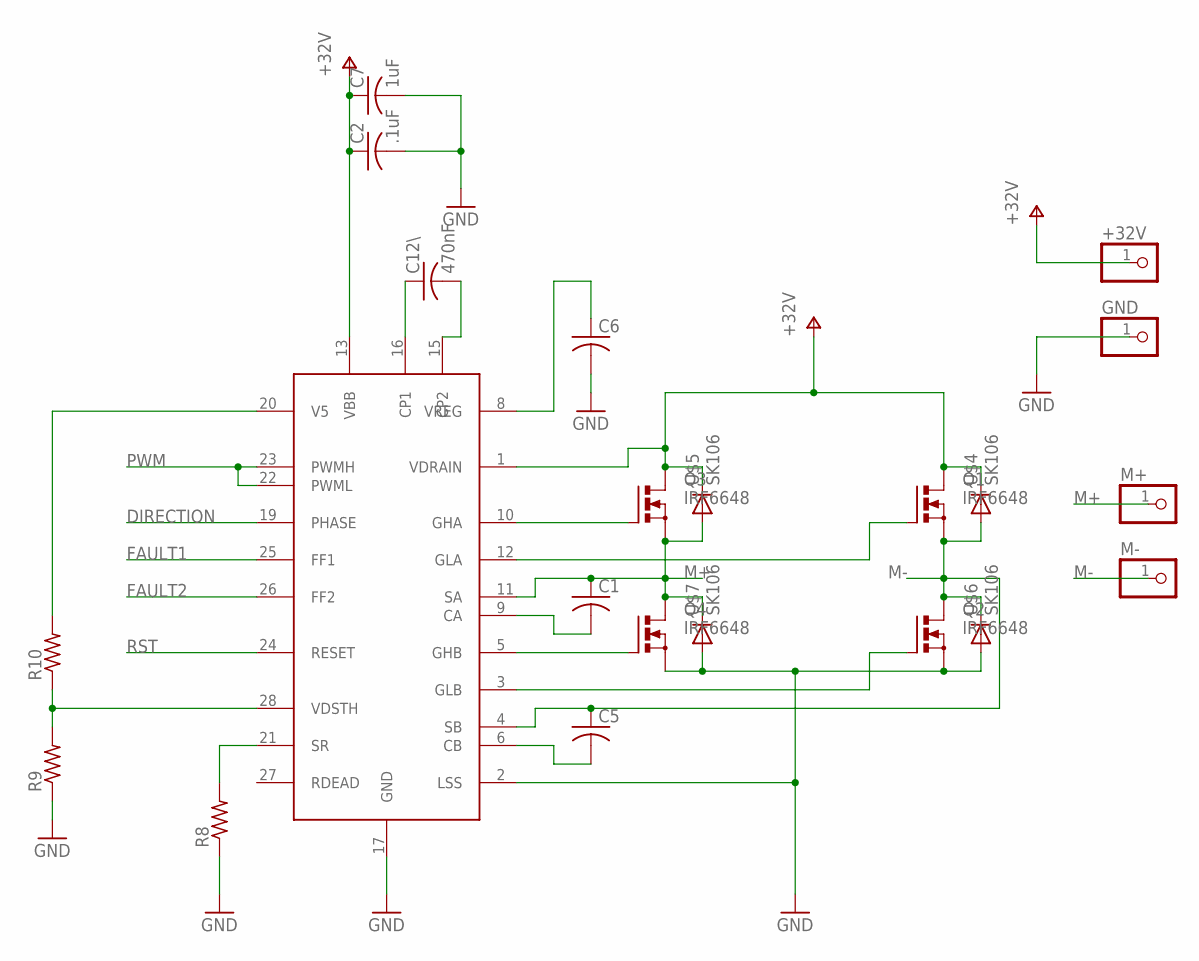
[picture p20: schematic motor.sch, sheet 1]

Parts:
+32V: PINHD-1X1; 1X01
C1, C5, C6: C-USC0603; C0603
C2: .1uF; C0603
C7: 1uF; C0603
C12\: 470nF; C0603
GND: PINHD-1X1; 1X01
M+: PINHD-1X1; 1X01
M-: PINHD-1X1; 1X01
Q1, Q2, Q3, Q4: IRF6648; DIRECTFET
R8, R9, R10: R-US_R0603; R0603
U$1: ALLEGRO-A3921; TSSOP28
U$4, U$5, U$6, U$7: SK106; DO-214AB

Connections:
+5V-A: R10.2, U$1.20 (V5)
+32V: +32V.1, C2.1, C7.1, Q1.D@1 (D), Q1.D@2 (D), Q1.D@3 (D), Q1.D@4 (D), Q3.D@1 (D), Q3.D@2 (D), Q3.D@3 (D), Q3.D@4 (D), U$1.1 (VDRAIN), U$1.13 (VBB), U$4.P$2 (C), U$5.P$2 (C); also elsewhere on the board
DIRECTION: U$1.19 (PHASE); also elsewhere on the board
FAULT1: U$1.25 (FF1); also elsewhere on the board
FAULT2: U$1.26 (FF2); also elsewhere on the board
GND: C2.2, C6.2, C7.2, GND.1, Q2.S@1 (S), Q2.S@2 (S), Q4.S@1 (S), Q4.S@2 (S), R8.1, R9.1, U$1.2 (LSS), U$1.17 (GND), U$6.P$1 (A), U$7.P$1 (A); also elsewhere on the board
M+: C1.1, M+.1, Q3.S@1 (S), Q3.S@2 (S), Q4.D@1 (D), Q4.D@2 (D), Q4.D@3 (D), Q4.D@4 (D), U$1.11 (SA), U$5.P$1 (A), U$7.P$2 (C)
M-: C5.1, M-.1, Q1.S@1 (S), Q1.S@2 (S), Q2.D@1 (D), Q2.D@2 (D), Q2.D@3 (D), Q2.D@4 (D), U$1.4 (SB), U$4.P$1 (A), U$6.P$2 (C)
unnamed: C6.1, U$1.8 (VREG)
unnamed: C12\.1, U$1.16 (CP1)
unnamed: C12\.2, U$1.15 (CP2)
unnamed: Q3.G, U$1.10 (GHA)
unnamed: Q1.G, U$1.12 (GLA)
unnamed: Q2.G, U$1.3 (GLB)
unnamed: C5.2, U$1.6 (CB)
unnamed: C1.2, U$1.9 (CA)
unnamed: R9.2, R10.1, U$1.28 (VDSTH)
unnamed: Q4.G, U$1.5 (GHB)
unnamed: R8.2, U$1.21 (SR)
PWM: U$1.22 (PWML), U$1.23 (PWMH); also elsewhere on the board
RST: U$1.24 (RESET); also elsewhere on the board

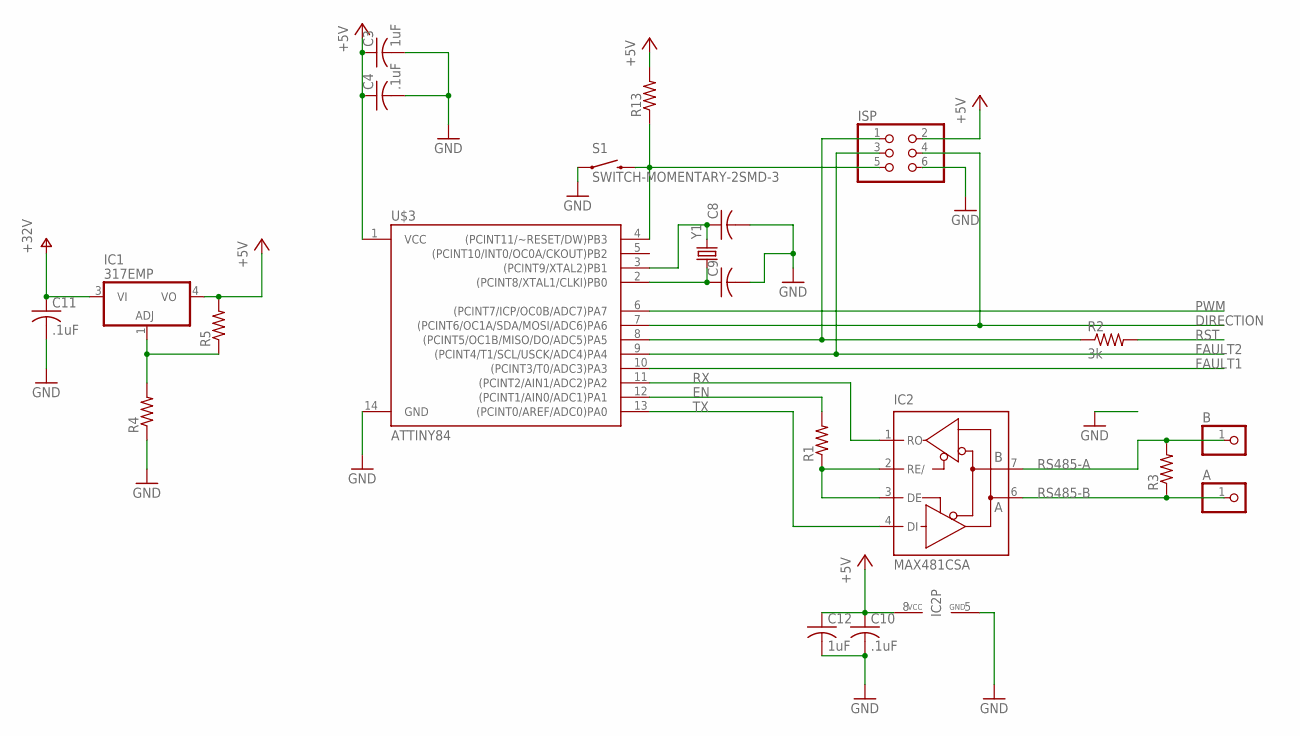
[picture p21: schematic motor.sch, sheet 2]

Parts:
A: PINHD-1X1; 1X01
B: PINHD-1X1; 1X01
C3, C12: 1uF; C0603
C4, C10, C11: .1uF; C0603
C8, C9: C-USC0603; C0603
IC1: 317EMP; SOT223
IC2: MAX481CSA; SO08
ISP: PINHD-2X3; 2X03
R1, R3, R4, R5, R13: R-US_R0603; R0603
R2: 3k; R0603
S1: SWITCH-MOMENTARY-2SMD-3; TACTILE_SWITCH_SMD-3
U$3: ATTINY84; SO14
Y1: CRYSTAL; MYSMD2_RESONATOR

Connections:
+5V: C3.1, C4.1, C10.1, C12.1, IC1.4 (VO), IC2.8 (VCC), ISP.2, R5.2, R13.2, U$3.1 (VCC)
+32V: C11.1, IC1.3 (VI); also elsewhere on the board
DIRECTION: ISP.4, U$3.7 ((PCINT6/OC1A/SDA/MOSI/ADC6)PA6); also elsewhere on the board
EN: R1.2, U$3.12 ((PCINT1/AIN0/ADC1)PA1)
FAULT1: U$3.10 ((PCINT3/T0/ADC3)PA3); also elsewhere on the board
FAULT2: ISP.3, U$3.9 ((PCINT4/T1/SCL/USCK/ADC4)PA4); also elsewhere on the board
GND: C3.2, C4.2, C8.2, C9.2, C10.2, C11.2, C12.2, IC2.5 (GND), ISP.6, R4.1, S1.1, U$3.14 (GND); also elsewhere on the board
unnamed: ISP.1, R2.1, U$3.8 ((PCINT5/OC1B/MISO/DO/ADC5)PA5)
unnamed: ISP.5, R13.1, S1.4 (2), U$3.4 ((PCINT11/~RESET/DW)PB3)
unnamed: IC2.2 (RE/), IC2.3 (DE), R1.1
unnamed: IC1.1 (ADJ), R4.2, R5.1
unnamed: C9.1, U$3.2 ((PCINT8/XTAL1/CLKI)PB0), Y1.1
unnamed: C8.1, U$3.3 ((PCINT9/XTAL2)PB1), Y1.3 (2)
PWM: U$3.6 ((PCINT7/ICP/OC0B/ADC7)PA7); also elsewhere on the board
RS485-A: B.1, IC2.7 (B), R3.2
RS485-B: A.1, IC2.6 (A), R3.1
RST: R2.2; also elsewhere on the board
RX: IC2.1 (RO), U$3.11 ((PCINT2/AIN1/ADC2)PA2)
TX: IC2.4 (DI), U$3.13 ((PCINT0/AREF/ADC0)PA0)

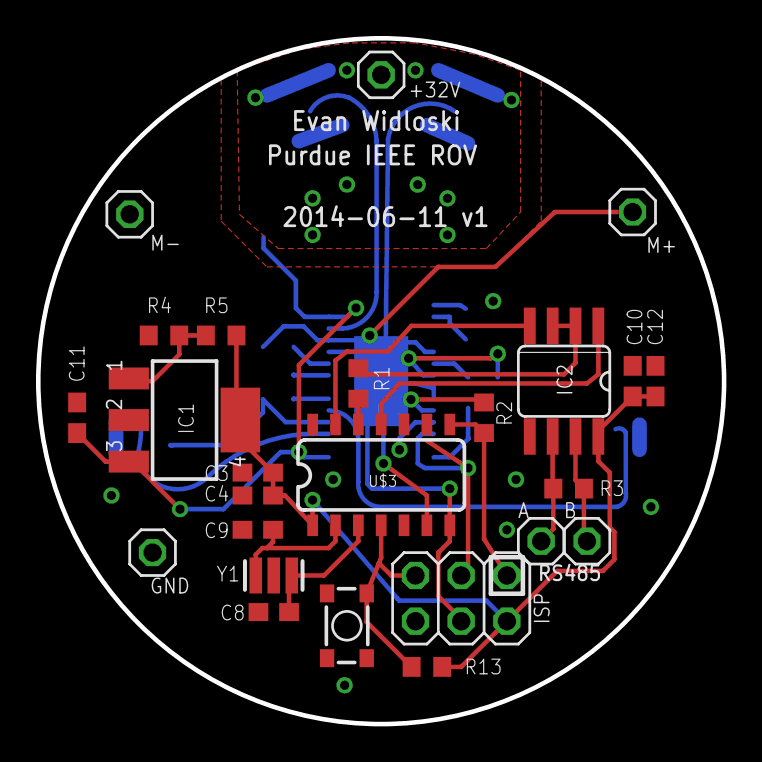
[picture p22: board motor.brd from above]

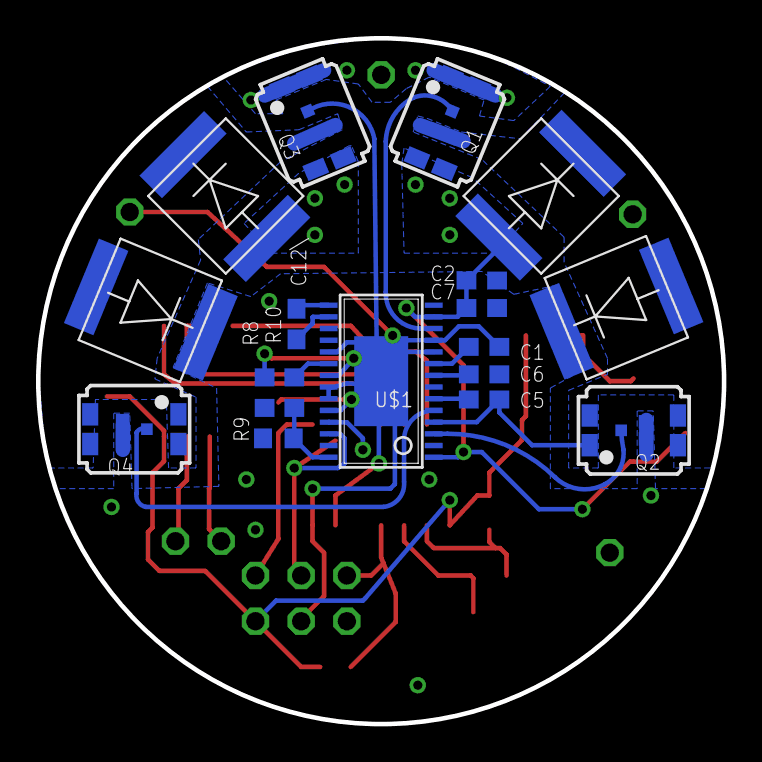
[picture p23: board motor.brd from below]

Board: 2 copper layers, 38.1 x 38.1 mm, 43 parts (18 on the bottom side), 33 nets.
